GeneralSyb/ChocoEF/Hardware/ChocoEF/ChocoEF.kicad_sch

## KiCad design Hardware/ChocoEF/ChocoEF.kicad_sch (2024-11-06)

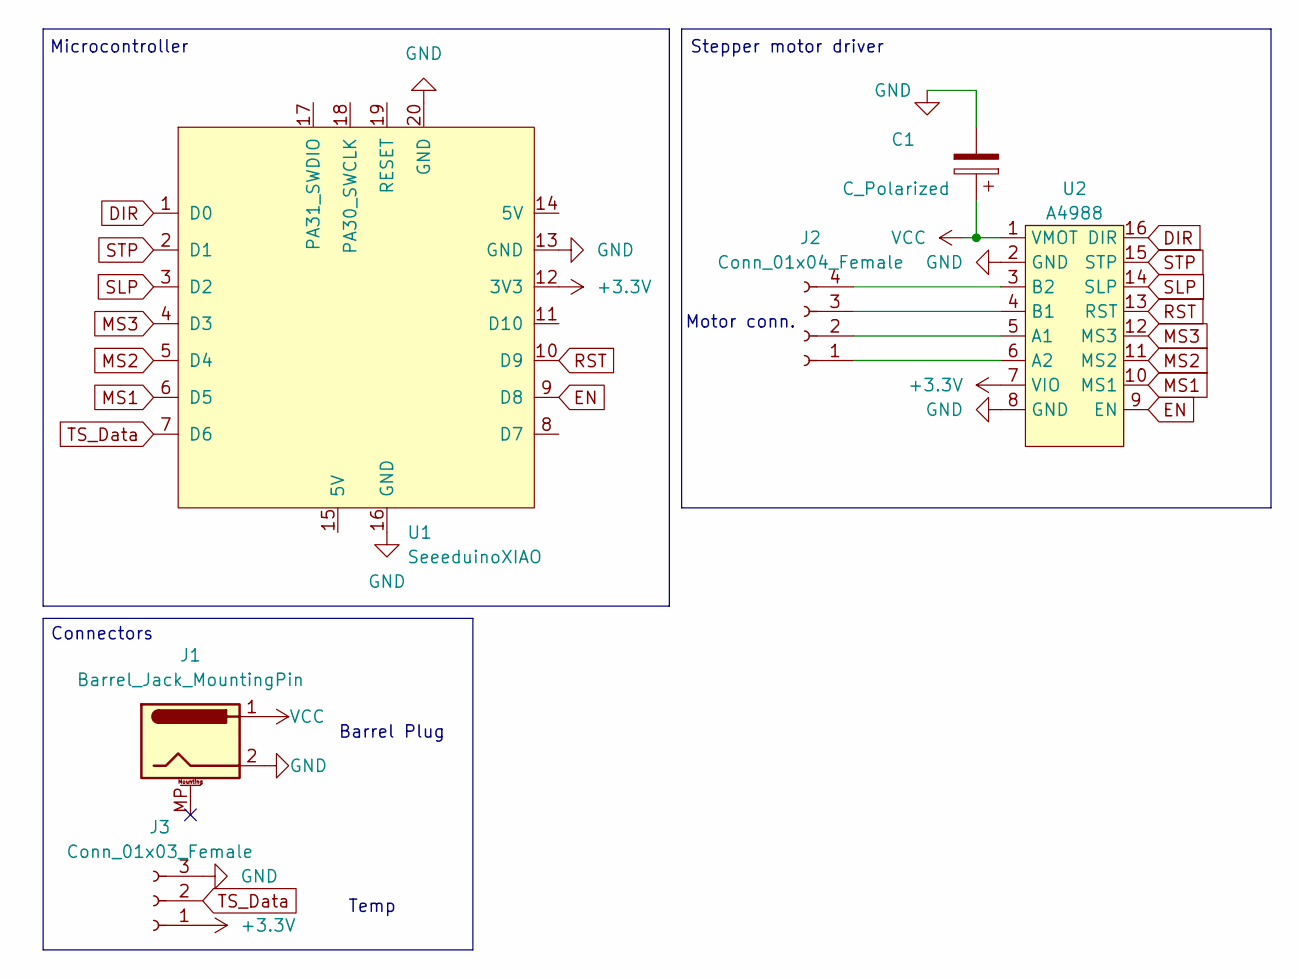
[picture p1: schematic ChocoEF.kicad_sch]

Parts:
C1: C_Polarized; CP_Radial_D10.0mm_P2.50mm_P5.00mm
J1: Barrel_Jack_MountingPin; BarrelJack_GCT_DCJ200-10-A_Horizontal
J2: Conn_01x04_Female; TerminalBlock_TE_282834-4_1x04_P2.54mm_Horizontal
J3: Conn_01x03_Female; TerminalBlock_TE_282834-3_1x03_P2.54mm_Horizontal
U1: SeeeduinoXIAO; Seeeduino XIAO-MOUDLE14P-2.54-21X17.8MM
U2: A4988

Connections:
+3.3V: J3.1, U1.12 (3V3), U2.7 (VIO)
DIR: U1.1 (D0), U2.16 (DIR)
EN: U1.9 (D8), U2.9 (EN)
GND: C1.2, J1.2, J3.3, U1.13 (GND), U1.16 (GND), U1.20 (GND), U2.2 (GND), U2.8 (GND)
MS1: U1.6 (D5), U2.10 (MS1)
MS2: U1.5 (D4), U2.11 (MS2)
MS3: U1.4 (D3), U2.12 (MS3)
unnamed: J2.1, U2.6 (A2)
unnamed: J2.2, U2.5 (A1)
unnamed: J2.3, U2.4 (B1)
unnamed: J2.4, U2.3 (B2)
RST: U1.10 (D9), U2.13 (RST)
SLP: U1.3 (D2), U2.14 (SLP)
STP: U1.2 (D1), U2.15 (STP)
TS_Data: J3.2, U1.7 (D6)
VCC: C1.1, J1.1, U2.1 (VMOT)

Notes on the sheet:
Connectors
Temp
Motor conn.
Barrel Plug
Microcontroller
Stepper motor driver
