GeneralSyb/ChocoEF/(commit log)

2024-11-06 fixed mistake with speed setting
    [focuser.ino]
2024-11-06 initial hardware upload
    [ChocoEF-B_Cu.gbr, ChocoEF-B_Mask.gbr, ChocoEF-B_Paste.gbr, ChocoEF-B_Silkscreen.gbr, ChocoEF-Edge_Cuts.gbr, ChocoEF-F_Cu.gbr, ChocoEF-F_Mask.gbr, ChocoEF-F_Paste.gbr]
